tobiascronenbroeck/balancer/BalancerV2/hykicad.kicad_pcb

## KiCad design BalancerV2/hykicad.kicad_pcb (2018-01-17)

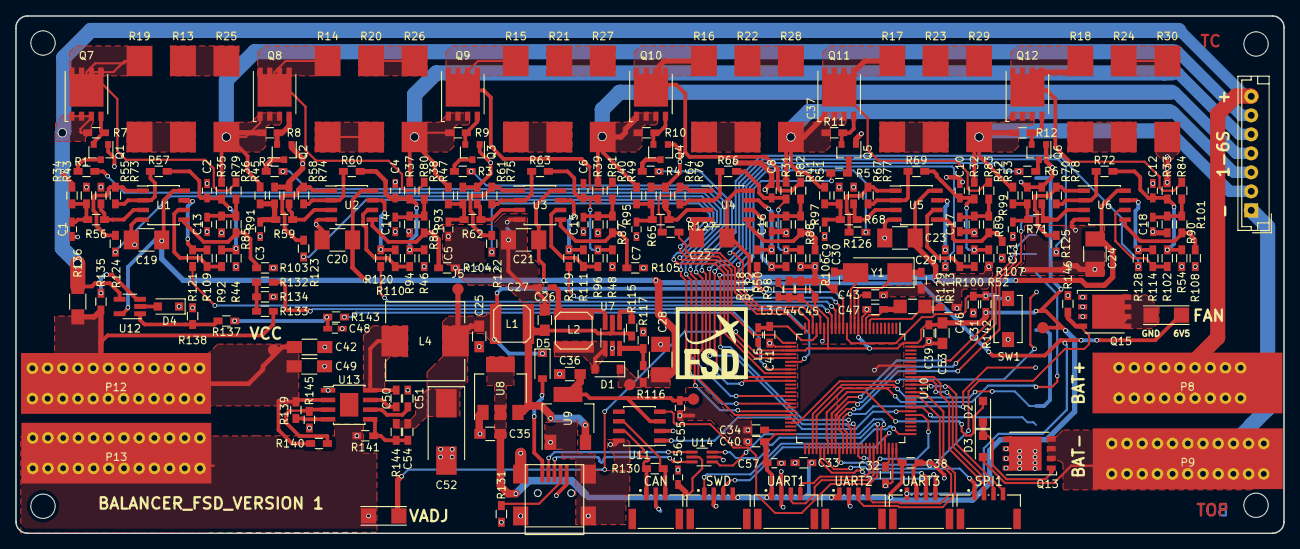
[picture p1: board hykicad.kicad_pcb from above]

Board: 2 copper layers, 166.9 x 68.1 mm, 264 parts (1 on the bottom side), 177 nets.

Parts:
32.768kHz1: Crystal_Small; Crystal_SMD_MicroCrystal_CC7V-T1A-2pin_3.2x1.5mm_HandSolder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
C1, C2, C3, C4, C5, C6, C7, C8, C9, C10, C11, C12, C13, C14, C15, C16, C17, C18, C27, C48, C55, C56, C57: 100nF; C_0603_HandSoldering
C19, C20, C21, C22, C23, C24, C28: 2.2uF 100V; C_1210_HandSoldering
C25, C26, C35, C36, C53: 4,7uF 16V; R_0805_HandSoldering
C29, C30, C46, C47: 18pF; R_0603_HandSoldering
C31, C33, C34, C37, C38, C39, C40, C41, C43, C45: 100nF; R_0603_HandSoldering
C32: 10uF; R_0603_HandSoldering
C42: 4.7uF 100V X7S; C_1206_HandSoldering
C44: 1uF; R_0603_HandSoldering
C49: 0.1uF 100V X7R; C_1206_HandSoldering
C50: 0.01uF 50V; R_0603_HandSoldering
C51: 1uF 50V; R_0603_HandSoldering
C52: Tantal 100uF 10V; CP_Tantalum_Case-V_EIA-7343-20_Hand
C54: 3.3nF 50V; R_0603_HandSoldering
D1, D5: D; D_SOD-123
D2, D3, D4: D_Schottky; D_SOD-123F
J1, J2, J3, J4, J5: CONN_01X01; Measurement_Point_Round-SMD-Pad_Small
L1, L2: 100uH/4818/0.4A; SELF-WE-TPC_M
L3, L5: 1uH 750mA; C_0603_HandSoldering
L4: 330uF 690mA; Inductor_Wurth_HCI-1040
P1: USB_OTG; USB_Mini-B
P2: CONN_01X03; pel_molex-CM-502386-03
P3, P4, P5, P6, P11: CONN_01X04; pel_molex-CM-502386-04
P7: CONN_01X07; JST_EH_B07B-EH-A_07x2.50mm_Straight
P8: BAT+; 4mmHorizontal
P9, P13: GND; 4mmHorizontal
P10: CONN_01X14; FPC_14
P12: VCC; 4mmHorizontal
P14, P15: CONN_01X02; FPC_2
Q1, Q2, Q3, Q4, Q5, Q6: BC846; SOT-23
Q7, Q8, Q9, Q10, Q11, Q12: PMOS_TDSON; TDSON-8-1_HandSoldering
Q13, Q15: NMOS_TDSON; TDSON-8-1_HandSoldering
R1, R2, R3, R4, R5, R6: 3,3k; R_0603_HandSoldering
R7, R8, R9, R10, R11, R12: 47k; R_0603_HandSoldering
R13, R14, R15, R16, R17, R18, R19, R20, R21, R22, R23, R24, R25, R26, R27, R28, R29, R30: 1R2; SM_3 Pad
R31, R32, R33, R34, R35, R36, R37, R38, R39, R40, R41, R42, R43, R44, R45, R46, R47, R48, R49, R50, R51, R52, R53, R54, R79, R80, R81, R82, R83, R84, R85, R86, R87, R88, R89, R90, R127, R134: 100K; R_0603_HandSoldering
R55, R56, R57, R58, R59, R60, R61, R62, R63, R64, R65, R66, R67, R68, R69, R70, R71, R72, R73, R74, R75, R76, R77, R78, R91, R92, R93, R94, R95, R96, R97, R98, R99, R100, R101, R102, R103, R104, R105, R106, R107, R108, R109, R110, R111, R112, R113, R114, R115, R118, R119, R120, R121, R122, R123, R124, R125, R126, R128, R129, R132, R133, R137, R142, R143, R146: 10K; R_0603_HandSoldering
R116: 123K; R_0603_HandSoldering
R117: 5K1; R_0603_HandSoldering
R130: 120R; R_0603_HandSoldering
R131: OTG Jumper; R_0603_HandSoldering
R135: 100R; R_0603_HandSoldering
R136: 5mR; R_1206_HandSoldering
R138: 5K; R_0603_HandSoldering
R139: 221K; R_0603_HandSoldering
R140: 51.1K; R_0603_HandSoldering
R141: 2.37k; R_0603_HandSoldering
R144: 10k; R_0603_HandSoldering
R145: 10.7K; R_0603_HandSoldering
SW1: SW_PUSH_SMALL_H; SW_SPST_EVQPE1
U1, U2, U3, U4, U5, U6: LM358; SOIC-8_3.9x4.9mm_Pitch1.27mm
U7: MP3216DJ-LF-Z; TSOT-23-6_MK06A_HandSoldering
U8: AP111733; SOT-223
U9: AP111750; SOT-223
U10: STM32F407VGTx; LQFP-100_14x14mm_Pitch0.5mm
U11: TJA1051T; SOIC-8_3.9x4.9mm_Pitch1.27mm
U12: LT6106; SOT-23-5_HandSoldering
U13: LM5017MR; TI_SO-PowerPAD-8
U14: NUF2221W1T2G; SOT-363_SC-70-6_Handsoldering
Y1: 8MHz; Crystal_SMD_0603-2pin_6.0x3.5mm_HandSoldering

Connections:
6,5V: C25.1, C52.1, C54.2, D5.1, J5.1, L1.1, L4.2, P6.1, P14.2, R144.1
32V: C19.1, C20.1, C21.1, C22.1, C23.1, C24.1, C28.1, D1.1, J1.1, R116.2, U1.8, U2.8, U3.8, U4.8, U5.8, U6.8, U12.5
+3V3: C33.1, C35.1, C37.1, C38.1, C39.1, C40.1, C43.2, C53.1, C56.1, C57.1, J4.1, L3.1, L5.1, P3.4, P4.1, P5.1, P10.1, P10.8, R142.1, U8.2, U8.4, U10.11, U10.19, U10.28, U10.50, U10.75, U10.100, U14.5
+5V: C36.1, C55.2, J3.1, U9.4, U11.3
BAT-: D3.2, P7.1, P9.1, Q13.2, Q13.3, Q13.4
CANuC+: P2.1, R130.1, U11.7
CANuC-: P2.3, R130.2, U11.6
CELL1: P7.2, Q12.1, Q12.2, Q12.3, R12.1, R29.1, R32.2, R42.2
CELL2: P7.3, Q11.1, Q11.2, Q11.3, R11.1, R28.1, R31.2, R41.2
CELL3: P7.4, Q10.1, Q10.2, Q10.3, R10.1, R27.1, R39.2, R40.2
CELL4: P7.5, Q9.1, Q9.2, Q9.3, R9.1, R26.1, R37.2, R38.2
CELL5: P7.6, Q8.1, Q8.2, Q8.3, R8.1, R25.1, R35.2, R36.2
CELL6: P7.7, P8.1, Q7.1, Q7.2, Q7.3, R7.1, R34.2, R136.2, U12.4
CS_LCD: P10.3, U10.61
CS_SD: P11.1, U10.60
CS_TOUCH: P10.11, U10.62
Cell1PWM: R1.2, U10.40
Cell2PWM: R2.2, U10.42
Cell3PWM: R3.2, U10.44
Cell4PWM: R4.2, U10.45
Cell5PWM: R5.2, U10.63
Cell6PWM: R6.2, U10.64
D/C_LCD: P10.5, U10.58
DAC1: P15.1, U10.29
ENFAN: Q15.4, R146.1, U10.65
ENGCON: D2.2, U10.57
GND: C1.2, C2.2, C3.2, C4.2, C5.2, C6.2, C7.2, C8.2, C9.2, C10.2, C11.2, C12.2, C13.2, C14.2, C15.2, C16.2, C17.2, C18.2, C19.2, C20.2, C21.2, C22.2, C23.2, C24.2, C25.2, C26.2, C27.1, C28.2, C29.1, C30.1, C31.1, C32.1, C33.2, C34.1, C35.2, C36.2, C37.2, C38.2, C39.2, C40.2, C41.1, C42.2, C43.1, C44.1, C45.1, C46.1, C47.1, C48.1, C49.2, C51.1, C52.2, C53.2, C55.1, C56.2, C57.2, D4.1, P1.5, P1.6, P2.2, P3.2, P4.2, P5.2, P6.2, P10.2, P13.1, P15.2, Q1.1, Q2.1, Q3.1, Q4.1, Q5.1, Q6.1, Q13.5, Q15.1, Q15.2, Q15.3, R30.1, R33.2, R43.2, R44.2, R45.2, R46.2, R47.2, R48.2, R49.2, R50.2, R51.2, R52.2, R53.2, R54.2, R55.1, R58.1, R61.1, R64.1, R67.1, R70.1, R85.2, R86.2, R87.2, R88.2, R89.2, R90.2, R103.2, R104.2, R105.2, R106.2, R107.2, R108.2, R117.1, R131.1, R134.2, R138.1, R141.2, R145.1, R146.2, SW1.1, U1.4, U2.4, U3.4, U4.4, U5.4, U6.4, U7.2, U8.1, U9.1, U10.10, U10.20, U10.27, U10.74, U10.94, U10.99, U11.2, U11.8, U13.1, U14.2
IBATSENSE: C48.2, R137.1, R143.1
IBZ1: R114.1, R128.2, U6.7
IBZ2: R113.1, R129.2, U5.7
IBZ3: R112.1, R118.1, U4.7
IBZ4: R111.1, R119.1, U3.7
IBZ5: R110.1, R120.1, U2.7
IBZ6: R109.1, R121.1, U1.7
unnamed: 32.768kHz1.1, C46.2, U10.8
unnamed: 32.768kHz1.2, C47.2, U10.9
unnamed: C1.1, R34.1, R43.1, R56.2
unnamed: C2.1, R35.1, R44.1, R57.2, R92.2
unnamed: C3.1, R36.1, R45.1, R59.2
unnamed: C4.1, R37.1, R46.1, R60.2, R94.2
unnamed: C5.1, R38.1, R47.1, R62.2
unnamed: C6.1, R39.1, R48.1, R63.2, R96.2
unnamed: C7.1, R40.1, R49.1, R65.2
unnamed: C8.1, R31.1, R50.1, R66.2, R98.2
unnamed: C9.1, R41.1, R51.1, R68.2
unnamed: C10.1, R32.1, R52.1, R69.2, R100.2
unnamed: C11.1, R42.1, R53.1, R71.2
unnamed: C12.1, R33.1, R54.1, R72.2, R102.2
unnamed: C13.1, R79.1, R85.1, R91.2
unnamed: C14.1, R80.1, R86.1, R93.2
unnamed: C15.1, R81.1, R87.1, R95.2
unnamed: C16.1, R82.1, R88.1, R97.2
unnamed: C17.1, R83.1, R89.1, R99.2
unnamed: C18.1, R84.1, R90.1, R101.2
unnamed: C26.1, L1.2, R115.2, U7.5, U8.3, U9.3
unnamed: C27.2, L2.1, U7.6
unnamed: C29.2, U10.12, Y1.1
unnamed: C30.2, U10.13, Y1.2
unnamed: C31.2, R142.2, SW1.2, U10.14
unnamed: C32.2, U10.73
unnamed: C34.2, U10.49
unnamed: C41.2, L5.2, U10.22
unnamed: C44.2, C45.2, L3.2, U10.21
unnamed: C50.1, L4.1, U13.8
unnamed: C50.2, U13.7
unnamed: C51.2, U13.6
unnamed: C54.1, R141.1, R144.2, U13.5
unnamed: D1.2, L2.2, U7.1
unnamed: D2.1, D3.1, Q13.1
unnamed: D4.2, U12.2
unnamed: D5.2, P1.1
unnamed: P1.4, R131.2
unnamed: P14.1, Q15.5
unnamed: Q1.2, Q7.4, R7.2
unnamed: Q1.3, R1.1
unnamed: Q2.2, Q8.4, R8.2
unnamed: Q2.3, R2.1
unnamed: Q3.2, Q9.4, R9.2
unnamed: Q3.3, R3.1
unnamed: Q4.3, R4.1
unnamed: Q5.3, R5.1
unnamed: Q6.3, R6.1
unnamed: Q7.5, R13.2, R79.2
unnamed: Q8.5, R14.2, R80.2
unnamed: Q9.5, R15.2, R81.2
unnamed: Q4.2, Q10.4, R10.2
unnamed: Q10.5, R16.2, R82.2
unnamed: Q5.2, Q11.4, R11.2
unnamed: Q11.5, R17.2, R83.2
unnamed: Q6.2, Q12.4, R12.2
unnamed: Q12.5, R18.2, R84.2
unnamed: R13.1, R19.2
unnamed: R14.1, R20.2
unnamed: R15.1, R21.2
unnamed: R16.1, R22.2
unnamed: R17.1, R23.2
unnamed: R18.1, R24.2
unnamed: R19.1, R25.2
unnamed: R20.1, R26.2
unnamed: R21.1, R27.2
unnamed: R22.1, R28.2
unnamed: R23.1, R29.2
unnamed: R24.1, R30.2
unnamed: R55.2, R56.1, U1.3
unnamed: R57.1, R73.2, U1.2
unnamed: R58.2, R59.1, U2.3
unnamed: R60.1, R74.2, U2.2
unnamed: R61.2, R62.1, U3.3
unnamed: R63.1, R75.2, U3.2
unnamed: R64.2, R65.1, U4.3
unnamed: R66.1, R76.2, U4.2
unnamed: R67.2, R68.1, U5.3
unnamed: R69.1, R77.2, U5.2
unnamed: R70.2, R71.1, U6.3
unnamed: R72.1, R78.2, U6.2
unnamed: R100.1, R113.2, U5.6
unnamed: R101.1, R108.1, U6.5
unnamed: R102.1, R114.2, U6.6
unnamed: R91.1, R103.1, U1.5
unnamed: R93.1, R104.1, U2.5
unnamed: R95.1, R105.1, U3.5
unnamed: R97.1, R106.1, U4.5
unnamed: R99.1, R107.1, U5.5
unnamed: R92.1, R109.2, U1.6
unnamed: R94.1, R110.2, U2.6
unnamed: R96.1, R111.2, U3.6
unnamed: R98.1, R112.2, U4.6
unnamed: R115.1, U7.4
unnamed: R116.1, R117.2, U7.3
unnamed: R118.2, U10.15
unnamed: R119.2, U10.16
unnamed: R120.2, U10.17
unnamed: R121.2, U10.18
unnamed: R122.2, U10.26
unnamed: R123.2, U10.34
unnamed: R124.2, U10.30
unnamed: R125.1, U10.23
unnamed: R126.1, U10.24
unnamed: R127.1, U10.25
unnamed: R128.1, U10.35
unnamed: R129.1, U10.36
unnamed: R132.2, U10.31
unnamed: R135.2, U12.3
unnamed: R137.2, R138.2, U12.1
unnamed: R139.1, U13.4
unnamed: R140.1, R145.2, U13.3
unnamed: R143.2, U10.33
unnamed: U10.81, U11.4
unnamed: U10.82, U11.1
RST_LCD: P10.4, U10.59
SPI1_MISO: P11.3, U10.90
SPI1_MOSI: P11.2, U10.91
SPI1_SCK: P11.4, U10.89
SPI2_MISO: P10.9, P10.13, U10.53
SPI2_MOSI: P10.6, P10.12, U10.54
SPI2_SCK: P10.7, P10.10, U10.47
SWCLK: P3.1, U10.76
SWDIO: P3.3, U10.72
TOUCH_IRQ: P10.14, U10.83
UART1_RX: P4.3, U10.69
UART1_TX: P4.4, U10.68
UART2_RX: P5.3, U10.87
UART2_TX: P5.4, U10.86
UART3_RX: P6.3, U10.56
UART3_TX: P6.4, U10.55
UBATSENSE: R132.1, R133.2, R134.1
USB+: P1.3, U14.6
USB-: P1.2, U14.4
USBuC+: U10.71, U14.1
USBuC-: U10.70, U14.3
UZ1: R78.1, R125.2, U6.1
UZ2: R77.1, R126.2, U5.1
UZ3: R76.1, R127.2, U4.1
UZ4: R75.1, R122.1, U3.1
UZ5: R74.1, R123.1, U2.1
UZ6: R73.1, R124.1, U1.1
VCC: C42.1, C49.1, J2.1, P12.1, R133.1, R135.1, R136.1, R139.2, R140.2, U13.2
