tobiascronenbroeck/balancer/Balancer.ioc

Mcu.UserName=STM32F407VGTx
PA0-WKUP.GPIO_Label=UZ6
PA0-WKUP.Signal=ADCx_IN0
PA1.GPIO_Label=UZ5
PA1.Signal=ADCx_IN1
PA10.Signal=USART1_RX
PA11.Signal=USB_OTG_FS_DM
PA12.Signal=USB_OTG_FS_DP
PA13.Signal=SYS_JTMS-SWDIO
PA14.Signal=SYS_JTCK-SWCLK
PA2.GPIO_Label=UZ4
PA2.Signal=ADCx_IN2
PA3.GPIO_Label=UZ3
PA3.Signal=ADCx_IN3
PA4.GPIO_Label=DAC1
PA4.Signal=COMP_DAC1_group
PA5.GPIO_Label=UZ1
PA5.Signal=ADCx_IN5
PA6.GPIO_Label=UBATSENSE
PA6.Signal=ADCx_IN6
PA9.Signal=USART1_TX
PB0.GPIO_Label=IBZ6
PB0.Signal=ADCx_IN8
PB1.GPIO_Label=IBZ5
PB1.Signal=ADCx_IN9
PB10.Signal=SPI2_SCK
PB14.Signal=SPI2_MISO
PB15.Signal=SPI2_MOSI
PB3.Signal=SPI1_SCK
PB4.Signal=SPI1_MISO
PB5.Signal=SPI1_MOSI
PC0.GPIO_Label=IBZ4
PC0.Signal=ADCx_IN10
PC1.GPIO_Label=IBZ3
PC1.Signal=ADCx_IN11
PC14-OSC32_IN.Signal=RCC_OSC32_IN
PC15-OSC32_OUT.Signal=RCC_OSC32_OUT
PC2.GPIO_Label=IBZ2
PC2.Signal=ADCx_IN12
PC3.GPIO_Label=IBZ1
PC3.Signal=ADCx_IN13
PC4.GPIO_Label=IBATSENSE
PC4.Signal=ADCx_IN14
PC5.GPIO_Label=UZ2
PC5.Signal=ADCx_IN15
PC6.GPIO_Label=Cell5PWM
PC6.Signal=S_TIM3_CH1
PC7.GPIO_Label=Cell6PWM
PC7.Signal=S_TIM3_CH2
PC8.GPIO_Label=ENFAN
PC8.Signal=S_TIM3_CH3
PD0.Signal=CAN1_RX
PD1.Signal=CAN1_TX
PD10.GPIO_Label=ENGCON
PD10.Signal=GPIO_Output
PD11.GPIO_Label=D/C_LCD
PD11.Signal=GPIO_Output
PD12.GPIO_Label=RST_LCD
PD12.Signal=GPIO_Output
PD13.GPIO_Label=CS_SD
PD13.Signal=GPIO_Output
PD14.GPIO_Label=CS_LCD
PD14.Signal=GPIO_Output
PD15.GPIO_Label=CS_TOUCH
PD15.Signal=GPIO_Output
PD2.GPIO_Label=Touch_IRQ
PD2.Signal=GPIO_Input
PD5.Signal=USART2_TX
PD6.Signal=USART2_RX
PD8.Signal=USART3_TX
PD9.Signal=USART3_RX
PE11.GPIO_Label=Cell2PWM
PE11.Signal=S_TIM1_CH2
PE13.GPIO_Label=Cell3PWM
PE13.Signal=S_TIM1_CH3
PE14.GPIO_Label=Cell4PWM
PE14.Signal=S_TIM1_CH4
PE9.GPIO_Label=Cell1PWM
PE9.Signal=S_TIM1_CH1
PH0-OSC_IN.Signal=RCC_OSC_IN
PH1-OSC_OUT.Signal=RCC_OSC_OUT
