tobiascronenbroeck/balancer/Inc/mxconstants.h

/**
  ******************************************************************************
  * File Name          : mxconstants.h
  * Description        : This file contains the common defines of the application
  ******************************************************************************
  *
  * COPYRIGHT(c) 2017 STMicroelectronics
  *
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
  ******************************************************************************
  */
/* Define to prevent recursive inclusion -------------------------------------*/
#ifndef __MXCONSTANT_H
#define __MXCONSTANT_H
  /* Includes ------------------------------------------------------------------*/


#define IBZ3_Pin GPIO_PIN_0
#define IBZ3_GPIO_Port GPIOC
#define IBZ4_Pin GPIO_PIN_1
#define IBZ4_GPIO_Port GPIOC
#define IBZ5_Pin GPIO_PIN_2
#define IBZ5_GPIO_Port GPIOC
#define IBZ6_Pin GPIO_PIN_3
#define IBZ6_GPIO_Port GPIOC
#define UZ1_Pin GPIO_PIN_0
#define UZ1_GPIO_Port GPIOA
#define UZ2_Pin GPIO_PIN_1
#define UZ2_GPIO_Port GPIOA
#define UZ3_Pin GPIO_PIN_2
#define UZ3_GPIO_Port GPIOA
#define UZ4_Pin GPIO_PIN_3
#define UZ4_GPIO_Port GPIOA
#define DAC1_Pin GPIO_PIN_4
#define DAC1_GPIO_Port GPIOA
#define UZ6_Pin GPIO_PIN_5
#define UZ6_GPIO_Port GPIOA
#define UBATSENSE_Pin GPIO_PIN_6
#define UBATSENSE_GPIO_Port GPIOA
#define IBATSENSE_Pin GPIO_PIN_4
#define IBATSENSE_GPIO_Port GPIOC
#define UZ5_Pin GPIO_PIN_5
#define UZ5_GPIO_Port GPIOC
#define IBZ1_Pin GPIO_PIN_0
#define IBZ1_GPIO_Port GPIOB
#define IBZ2_Pin GPIO_PIN_1
#define IBZ2_GPIO_Port GPIOB
#define Cell1PWM_Pin GPIO_PIN_9
#define Cell1PWM_GPIO_Port GPIOE
#define Cell2PWM_Pin GPIO_PIN_11
#define Cell2PWM_GPIO_Port GPIOE
#define Cell3PWM_Pin GPIO_PIN_13
#define Cell3PWM_GPIO_Port GPIOE
#define Cell4PWM_Pin GPIO_PIN_14
#define Cell4PWM_GPIO_Port GPIOE
#define ENGCON_Pin GPIO_PIN_10
#define ENGCON_GPIO_Port GPIOD
#define D_C_LCD_Pin GPIO_PIN_11
#define D_C_LCD_GPIO_Port GPIOD
#define RST_LCD_Pin GPIO_PIN_12
#define RST_LCD_GPIO_Port GPIOD
#define CS_SD_Pin GPIO_PIN_13
#define CS_SD_GPIO_Port GPIOD
#define CS_LCD_Pin GPIO_PIN_14
#define CS_LCD_GPIO_Port GPIOD
#define CS_TOUCH_Pin GPIO_PIN_15
#define CS_TOUCH_GPIO_Port GPIOD
#define Cell5PWM_Pin GPIO_PIN_6
#define Cell5PWM_GPIO_Port GPIOC
#define Cell6PWM_Pin GPIO_PIN_7
#define Cell6PWM_GPIO_Port GPIOC
#define ENFAN_Pin GPIO_PIN_8
#define ENFAN_GPIO_Port GPIOC
#define Touch_IRQ_Pin GPIO_PIN_2
#define Touch_IRQ_GPIO_Port GPIOD
/**
  * @}
  */ 

/**
  * @}
*/ 

#endif /* __MXCONSTANT_H */
/************************ (C) COPYRIGHT STMicroelectronics *****END OF FILE****/
