tobiascronenbroeck/balancer/(commit log)

2017-10-10 Init Balancer HAL
    [Balancer Debug.cfg]
2017-10-11 ST Firmware Update / improved UART Write Method
2017-10-11 Adding DMA Support for ADC Conversion
2017-10-11 omit hal adc start for the moment
2017-10-13 Set Sampling Loops for each ADC Channel to 144 Starting ADC_DMA
2017-10-13 Added Voltage Calculation for ADCs
2017-10-15 Added ADC Reading
2017-10-15 Added PWM Output
2017-10-16 Added Battery GND Connection
2017-10-16 Added internal Temp Sensor Conversion & Rearranged ADC order
2017-10-17 Added calibration mode to ADC Vref rail
2017-10-17 First Calibration & Voltage to UART
2017-10-17 Calibration of UBat ADC
2017-10-18 1. Calibration for all Channels
2017-11-02 Added DAC DMA Init
2018-01-04 Added Voltage Output
2018-01-17 Added Schematics
    [Calib.xlsx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]
2018-01-17 Improved ADC Averaging & Circuit Adjustments
